jacgoudsmit/L-Star/(threads)

Thread 1 (2015-12-17):

Q: Would there be any major improvements for using a 6.25 MHz crystal?

cbmeeks, 2015-12-17:
I know timing is tight.  But, how would running the Propeller at 6.25 MHz (25 MIPS) enhance the emulation?  Assuming there would be any enhancements at all.

Do you think the 65C02 could be pushed closer to 2 MHz?

I hope to build this really soon.  :-)

From what I understand, the real limitations here are the pin counts and RAM.

Anyway, thanks for such a great project!!!

cbmeeks, 2015-12-17:
Sorry, I didn't see where you explicitly talked about this in the clock source.  Feel free to close this.

Thanks!

jacgoudsmit, 2015-12-17:
Hi cbmeeks.

While I was developing the Propeddle and L-Star, I was hoping I could make the 65(c)02 run faster than 1MHz, but there were several things that slowed things down, as compared to a (hypothetical) electronic solution instead of a sequential (programmed) solution.

For one thing, the Propeller only lets you read all the 32 pins at once. It doesn't allow a subset of the pins to be read. For this particular project, it would be great if I could use one single instruction to read the address bus or the data bus, without the need to shift/rotate the bits and/or mask them with a bitmask. That would save at least two instructions per 6502 cycle which is more than 10%.

Another problem is that it's almost unavoidable to have at least one hub instruction in the loop, and hub instructions take at least 8 Propeller cycles in the best case, or up to 23 cycles in the worst case. It took me a long time to design the original main loop of Propeddle in such a way that it would finish on time for the next 6502 cycle because of this.

If you want to run the 6502 faster while bitbanging it with a Propeller, you can probably do so if you add more electronics. My purpose with Propeddle and L-Star was to provide a flexible platform that could emulate many 1MHz 6502 systems (or could be used to design your own, to some extent). But if you want to use my ideas for something more specific, you can. For example, the Superboard III computer by Vince Briel at brielcomputers.com uses many of my ideas, but has an extenal address decoder to re-code the four address bus lines A15-A12 into three "virtual" address lines VA14-VA12 which made the logic for the Propeller firmware a little simpler and saved an I/O pin. If you want to use a separate Propeller just for video, for example, you can save a lot of pins too, by using an external address decoder. You could even make a system where the Propeller is sort of a GPU: just "send" it a command to draw (say) a circle and it does it without letting the 6502 wait, and such a system would only need 10 pins to interface with the 6502: a Chip Enable of sorts (with an external address decoder), the R/~W line and 8 data bus lines.

And you could do something that many 6502 systems from the 1980s did: run the 6502 on 2MHz or even faster for access to memory (using fast SRAM and 74F or 74AC address decoding logic for example) and slow the clock down or drop the RDY line to generate wait states when something needs to be done by the Propeller or some other slow peripherals.

Good luck!

cbmeeks, 2015-12-18:
Thanks for the great information!

Haha...I've come to a similar conclusion.  Bottom line is that if you want more than 2MHz then you need external logic.  Either an entire Propeller running all 8 COGS to address memory (and that's still debatable) or discrete logic (or CPLD/FPGA) to handle address decoding.

I'm more than likely going to use an entire Propeller for video (and maybe audio) and have the CPU pass it commands.  The TMS9918 worked this way.  Many people hated that.  And for good reason.  You have to burn cycles to send a command and then more cycles to send address/data bytes.  A lot more work than a simple LDA #$10; STA $D000.

Of course you can do things to help out like having commands that allow paging and serializing bytes in so that consecutive bytes are just data bytes.  Very little overhead that way (TMS9918 also did this).

I'm brainstorming many ideas.  One idea is to have a "blitter" using the Propeller.  The 65C02 could send it some blitter commands and then the Propeller could move large amounts of RAM around the display memory, etc.

Effectively, it would be a sort of "copper list".  :-)

Oh, BTW, the way you bootstrap the 65C02 is genius.  Using the built in program counter of the 65C02 to save address line pins...cheating!!  But brilliant.  :-D

jacgoudsmit, 2015-12-18:
The bootstrapping method was Dennis Ferron's idea. In his "Prop-6502 laptop" project he used NOP instructions but those are 1-byte, 2 cycles so the address only increases once every other clock pulse, I improved it by using CMP immediate, which is a 2 byte, 2 cycle instruction so the download (or upload which is not implemented yet but should be pretty trivial) goes twice as fast.

Dennis used the Reset vector to download the bootstrap code, but I use NMI. The advantages are that I can do an upload or download (sort of a DMA by cheating operation) while the system is running (e.g. to emulate a floppy disk, to "insert a cartridge", or to implement a hibernate-and-resume by reading/writing from/to EEPROM). The NMI combined with the RTI instruction fixes the problem that the flags are destroyed by the repeated CMP instruction. Also, using NMI and keeping the NMI input low (it's edge-triggered) makes it impossible for other hardware to interrupt the process.

On the other hand, forcing an interrupt by executing a BRK instruction (and letting the Propeller check for the IRQ vector fetch) also gives an opportunity to do automatic downloads/uploads from the Propeller.

Closed 2015-12-17.

Thread 2 (2016-02-09):

Constantly resetting...

cbmeeks, 2016-02-09:
I've wired this up to a breadboard.  So far, I just have a Propeller and a 65C02 wired up.

I have tested the Propeller with a blinky demo and it seems to be stable.

When wire up the 65C02, it displays:

> L-STAR (c) 2014 JAC GOUDSMIT
> HUB RAM BYTES:

And it just repeats that over and over.  I am using the built-in Propeller tools serial terminal at 115200, echo on.

I've also connected the TV out and see the screen blinking.

I'm pretty sure I have proper decoupling caps on everything, getting 3.2xx volts at the 65C02.  Using a benchtop power supply.

Using a 5 MHz crystal.

Any ideas?

Thanks

jacgoudsmit, 2016-02-09:
I've seen this before; I think it happens when you don't have a Prop Plug connected. I think the schematic is missing a couple of pull-up resistors for P31 and Reset (propeller) so when you disconnect the Prop plug, those lines start floating and oscillating and catching interference and other nasty stuff.

If you add two 10K resistors -- one between 3.3V and P31, and one between 3.3V and the Reset pin on the propeller -- or leave the Prop Plug connected, the problem should go away. I think you can even leave the Prop plug connected with no USB connection.

Let me know if that works!

===Jac

cbmeeks, 2016-02-09:
Thanks for the quick reply.

Unfortunately, I've tried it with and without the PropPlug and it does the same thing either way.

Also, I need the PropPlug for the serial terminal.  :-)

I have a 10k pullup on P29 as per the schematics in the Propeller manual.  Plus, other spin programs work just fine.

jacgoudsmit, 2016-02-09:
Hmmm...

To check if it's a hardware problem or a software problem, try inserting this before the call to clock.Init in Apple1.spin (which should be the top level file).

```spin
  repeat
    i:=0
```

This should send the main cog into an infinite loop and you should see the entire message including the "16384" on the serial port and on the monitor. After that, nothing should happen. If it still keeps resetting, it's most likely a hardware problem, e.g. interference between the serial port or video output to the reset line, or a power level that sags too much once the program gets busy (you have the Propeller BOE pin grounded, right?)

If that works okay, move the `repeat i:=0` instruction below the clock.init call, then further down etc.

You may also want to try running the 65C02 at a lower frequency, to see if it makes a difference. Simply change the clock.init call parameter to another value. You can even change the clock module so it doesn't call freq.Synth, and then control the hw#PIN_CLK0 output pin some other way, e.g. with a toggle switch, or from the serial port. The 65C02 is fully static so you can run it as slowly as you want. With a 5MHz crystal, you can run it up to 1MHz otherwise some of the helper cogs may not be able to keep up, but lower speeds are always okay.

Another thing to try is to delete the video module (comment out all references to the "tv" object in SerKbd1TV.spin). In a similar way you can delete the keyboard module (remove all references to kbd in the SerKbd1TV.spin file). This might give you some idea where any hardware problems are coming from.

Let me know if any of this helps...

cbmeeks, 2016-02-09:
It's working!

OK, it was a hardware problem.  My "monster" breadboard that I built was dropping too much power.  I moved the bench power leads closer to the actual circuit and now I get a stable image.

Sweet!

My scope is now showing a good solid 1.000MHz signal with an occasional drop to 960KHz.  But that's probably due to interference, breadboard, etc.

Thanks!

Now, how do I use the Woz monitor?  lol
Or basic?

cbmeeks, 2016-02-09:
Never mind.  I figured it out.  :-)

It's totally working now.

Had to `3C00 R` and that jumped to BASIC.

AWESOME!!

Probably going to have a board made!  Do you have any extras to sell?

Thanks!

jacgoudsmit, 2016-02-09:
Great! Good to hear you got it working.

I think I have one unpopulated PCB for L-Star, I'll send you an email.

For those reading along: You can order PCB's [here](https://oshpark.com/shared_projects/ATxyrTo7). A list of parts is [here](https://www.mouser.com/ProjectManager/ProjectDetail.aspx?ProjectGUID=144CCFEE-70F9-44B8-83F5-9934C3685E55). NOTE: the OSHPark and Mouser files are based on the [initial release](https://github.com/jacgoudsmit/L-Star/releases/tag/0.1); I've made several minor changes to the hardware design since then, but the latest software should still work.

The BOM on mouser.com doesn't include a power supply, keyboard, monitor or Prop Plug. You will also need a computer running the Parallax Propeller Tool to build the software. NOTE: There are currently no build instructions but those who have experience with soldering should be able to put this together pretty easily.

cbmeeks, 2016-02-09:
Great!

Have you ever used http://www.pcbway.com for PCB's?

I love the purple look of OSH Park but PCB appears to be even cheaper (coming from China).

Bil Herd uses them according to his YouTube video.

Anyway, thanks for such an awesome project.  I've been trying to solder up a small protoboard for this but all of the wires are really a drag to solder.

Thanks!

Closed 2016-02-11.

Thread 3 (2016-02-10):

Question: In Clock.spin, how is the ~~ used?

cbmeeks, 2016-02-10:
I searched the manual and it mentions "Sign-Extend 15" for the ~~ directive but I'm not understanding how this applies to the following code from `Clock.spin`:

`' Initialize the clock and SDA pins as output, and set them both high for now,`
`' so that the 6502 access cogs can ready themselves by waiting for CLK0 to go low.`
`  outa[hw#pin_SDA]~~                                    '`
`  dira[hw#pin_SDA]~~                                    ' The SDA pin must remain high so the EEPROM doesn't get activated.`
`  outa[hw#pin_CLK0]~~                                   ' Override the clock with a high signal for now`
`  dira[hw#pin_CLK0]~~                                   ' Set CLK0 pin to output for Phase 0 clock`

1) What is the `~~` actually doing in these examples?

2)  What is the reason for setting the value of the pin (I assume HIGH) *before* the direction is set on the same pin?

Thanks!

_BTW, my apologies if the Parallax forums would be a better place to ask this since it applies to `Spin` more than `L-Star`.  Also, I wasn't sure how to flag this as a question instead of an issue._

jacgoudsmit, 2016-02-10:
1) The ~~ operator can be used in two ways: ~~X means sign-extend bit 15,
but X~~ means set all bits. So in those examples it simply sets the pins to
1 and the directions to output. See page 157 and 158 of the Propeller
Manual (v1.2).

2) Setting the value of a pin before setting the direction prevents extra
pulses on the output pin. After a Reset, the OUTA register is reset to 0,
so if I would change the direction first, the pin's output transistors
would go from a situation where they're not pulling the pin high or low, to
a situation where they're pulling the output low until the OUTA bit changes
after the next instruction. By setting the bits in OUTA first, followed by
setting the pin direction to Output, the pin changes from
not-pulling-high-or-low to pulling-low. This is not Propeller-specific or
L-Star specific, it's just a general principle for all situations where an
electronic part can pull a signal low or high or "none of the above"
(commonly referred to as High-Z).

===Jac

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

cbmeeks, 2016-02-10:
Yes, that makes sense.

Thanks for the explanation.

Closed 2016-02-11.

Thread 7 (2018-03-14):

No level shifters in design

BrianHoldsworth, 2018-03-14:
Well, I suppose this is not an "Issue" because your design obviously works fine without level shifters between the 5V 6502 and the 3.3V propeller. The only reason I am bringing it up is because I tried researching this on the Parallax forum and there was a strong consensus that level shifting was needed to use the Propeller with TTL parts like the 6502.

As a point of "community knowledge sharing", perhaps the rationale for your design without level-shifters can be added to the docs or part of a not-yet-seeded GitHub Wiki? Also any idea if the L-Star also works with an NMOS 6502 and its slightly different logic levels?

jacgoudsmit, 2018-03-14:
L-Star uses a Western Design Center 65C02 and runs it at 3.3V, not 5V. This is within the specifications of the WDC datasheet.

In fact, the only reason there is 5V on board is for the PS/2 keyboard and for future expansion boards (I've been thinking of changing the power supply circuit to put the 5V and 3.3V regulators in parallel instead of in series to allow more current for the 5V rail, but that's a possible future enhancement). If an expansion board will have 5V-only hardware, it may also need level shifters. I'm sure I will bring up the subject in the documentation for such expansion board!

The Propeller is not 5V tolerant according to the datasheet. I think I read on the Propeller forums that the Propeller has over-voltage protection (Zener) diodes on all I/O pins, but they're not designed to sink enough current. However, interfacing with 5V is possible: Chris Savage who used to work at Parallax, had an article on his website (I can't find it right now) saying you would need resistors of 2700 ohms between a 5V circuit and input pins on the Propeller, to protect the Propeller. When a Propeller pin is used as output, it's compatible with TTL, at least with TTL-HC.

L-Star was based on my earlier Propeddle project (elsewhere in my Github). On Propeddle, I made it possible to use either a regular 6502 (at 5V) or the WDC 65C02 (at 3.3V or 5V). I used 2700 ohm resistors in that circuit which could be shorted out when running on 3.3V. When using a 5V 6502, the resistors worked to protect the Propeller from the 5V from the 6502 and didn't seem to cause any problems when the Propeller was pulling the data bus high or low.

In conclusion:
- On L-Star by itself, this is not an issue because the entire system runs at 3.3V except for the PS/2 keyboard (and the PS/2 keyboard is connected to the Propeller through a voltage divider based on Parallax sample schematics). No level shifters are needed because the voltages are the same.
- My experience is that the NMOS 6502 at 5V can be interfaced with the Propeller at 3.3V by using 2700 Ohm resistors in series, but I didn't use an oscilloscope (or anything else) to verify that signals were within limits.
- I realize that "works for me" is not statistically valid but until I design an expansion board that runs on 5V, I won't have to worry about it. When I do, I'll be sure to bring up the subject in the documentation.

Thanks!

BrianHoldsworth, 2018-03-14:
Thanks for the detailed response and for sharing your knowledge on this topic. I completely missed that you were running the 65C02 at 3.3V, or that even being a possible solution.

Closed 2018-03-14.

Thread 8 (2019-03-05):

80-column 1pin driver

konimaru, 2019-03-05:
For the record (since the OBEX managed to break the link), there is an 80 column version (@80MHz) or the 1pin TV driver.

[80 column version](http://forums.parallax.com/discussion/comment/1265858/#Comment_1265858)

jacgoudsmit, 2019-03-05:
Thanks!

So far there hasn't been a need for an 80-column 1-pin driver in L-Star but it might come in handy in the future.

80 columns is not really readable on most standard definition color TV screens though...

konimaru, 2019-03-05:
Fair enough, anyway it's not getting lost (anymore). When I tested it I had a nice big 32" TV available. IIRC there is even an evidence picture in the forum thread.

I haven't looked in detail at your changes but did you move the font to hub RAM again?

jacgoudsmit, 2019-03-06:
I saw the picture in the thread. It looks great! My 14" Trinitron will
definitely show it as well as your monitor, but I've used 27" CRT color
TV's that make a mess out of anything over 64 columns.

Monochrome monitors also have higher resolutions of course. I wouldn't be
surprised if my 5" black and white CRT TV would generate 80 colums without
blurring things too much.

For the OSI project, I had to move the font to the hub because it's 256
characters (not 128). The font would fill the entire cog. Unfortunately
that means that if the video clock is too high, the code can't retrieve the
video data fast enough. I think I did some calculations and wrote some
comments in the module about how far you can go.

===Jac

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
