jacgoudsmit/L-Star/(list of files, drawings)

Other design files:
Hardware/Fritzing/L-Star.fzz
