jacgoudsmit/L-Star/Software/PET2001/Debug_1pinTV.spin

'' ┌──────────────────────────────────────────────────────────────────────────┐
'' │ One Pin TV Text Driver used as Debug screen                        v1.2x │
'' ├──────────────────────────────────────────────────────────────────────────┤
'' │  Authors:  (c) 2009 Eric Ball                        (original 1-pinTV)  │
'' │            (c) 2010 "Cluso99" (Ray Rodrick)          (almost rewrite)    │
'' │            (c) 2014 kuroneko (Marko Lukat)                               │
'' │            AiChip_SmallFont_Atari_lsb_001.spin       (font)              │
'' │  License   MIT License - See end of file for terms of use                │
'' ├──────────────────────────────────────────────────────────────────────────┤
'' │  Forum:    http://forums.parallax.com/forums/default.aspx?f=25&m=431556  │
'' └──────────────────────────────────────────────────────────────────────────┘
''
'' Original One Pin TV Text Driver demo (C) 2009-07-09 Eric Ball
'' Font included is from "AiChip_SmallFont_Atari_lsb_001.spin"  (by hippy???)
'' Modified/rewritten by Cluso99:
'' RR20100214   _rr015  working for 64x28 NTSC & 64x32 PAL @5MHz
''                        added debug to show calculated values
'' RR20100215   _rr016  remove msb font mode (if reqd, reverse the font in hub)
''              _rr017  remove standby check & function (i.e. do setup once only)
''              _rr018
''              _rr019  use cog screen buffer 1024 bytes (64x16)
''              _rr020  cog screen buffer (40x16)
'' RR20100219   _rr022  cog font (only lsb font supported)
''                       (works but short of font space)
''              _rr023  add inverse bit8
''              _rr025  remove calcs, fix for 5MHz 40x25 chars, ok
''                      test release
''              _rr026  remove all parameter calcs (use "1pinTV_calcs.spin" to calculate parameters)
''              _rr027  add ASCII subset to cog (not VT100)
''              _rr033  cls, bs, cr, lf working except does not scroll
'' RR20100220   _rr035  add flashing cursor, can, home, right, left, up, down (left/right bug)
''              _rr037  scroll, left, right working :-)
''              _rr038  test with 1-pin Keyboard
''              _rr040  automatically set for 5MHz,6.25, 6.5, 13.5MHz xtal values for ifrqa in xfrqa
'' RR20100226   _rr041  tested ok.
'' RR20100228   Debug version: Rename "Debug_1pinTV.spin" and modify.
''              Output methods: chr/out/tx, str, dec, hex
'' RR20100302   v1.01   add PAL parameters
'' RR20100304   v1.02   modify font to speed up pix generation (each long is stored in a seperate half font)
''                       saved 2 instrctions in :active loop
''              v1.03   add constants for 64x25 & 80x25 NTSC and test various clock frequencies
'' RR20100306   v1.04   remove double height option
'' RR20100315   v1.05   change call doblank2 -> doblank (saves space) at lines 1797
''                      movs vscl,xsync & movs vscl,xbackp s/be mov
'' RR20100318   v1.06   use hub TV cog code for screen buffer
''                        (note that for 80*25 DAT will need extending to prevent overwrite)
'' RR20100318   v1.07   DAT extended to take care in case screen is 80*25
'' RR20100318   v1.08   add methods clear, home, gotoxy, cr (in spin)
'' RR20100424   v1.10   improve documentation only
'' RR20100503   _rr050  code mods (MOVS VSCL,#...); new NTSC timing
''                      move vt100 tasks to blank line code
'' RR20100505   v1.20   include automatic parameter calculation as well as predefined versions
''                        add timing diagram
'' RR20100505   _rr051  code shrink for VT100 space; allow variable row size & fill hub when required;
''                      auto clear screen at start (reqd)
'' RR20100505   v1.25   release
'' ML20140506   v1.26   all features fully operational @80MHz
''              v1.27   gotoxy now passes cursor address to speed up operation
''
' ─────────────────────────────────────────────────────────────────────────────────────────────────
' * This routine displays 40/64/80 characters by 25 lines using an 8x8 pixel text font.
' * Other screen sizes are permitted but the font is fixed.
' * NTSC or PAL can be selected. A flashing cusor is automatically displayed.
' * Only 1 propeller pin is used with a simple series resistor to give TV B&W video out.
' * Ideally suited to an additional debug monitor in your program, or as main display terminal.
' * The driver resides in the cog, together with the font and a simple terminal emulator.
' * The screen buffer resides in hub re-using the codespace originaly occupied by the cog code,
'    resulting in a minimum hub footprint.
' * If required, the user program may also write to the screen buffer directly.
' * You may also be interested in the 1pinKBD driver which uses 1 propeller pin connected to a
'    PS2 style Keyboard (or some DIN5 and USB keyboards via an adapter cable/plug).
' ─────────────────────────────────────────────────────────────────────────────────────────────────
' ┌─────────────┬───────┬───────┬───────┬───────┬───────┐
' │             │ 80MHz │ 96MHz │100MHz │104MHz │108MHz │
' ├─────────────┼───────┼───────┼───────┼───────┼───────┤
' │ NTSC 40X25  │  Yes  │  Yes  │  Yes  │  Yes  │  Yes  │
' ├─────────────┼───────┼───────┼───────┼───────┼───────┤
' │ NTSC 60X25  │  Yes  │  Yes  │  Yes  │  Yes  │  Yes  │
' ├─────────────┼───────┼───────┼───────┼───────┼───────┤
' │ NTSC 64X25  │  Yes  │  Yes  │  Yes  │  Yes  │  Yes  │
' ├─────────────┼───────┼───────┼───────┼───────┼───────┤
' │ NTSC 64X28  │  Yes  │  Yes  │  Yes  │  Yes  │  Yes  │
' ├─────────────┼───────┼───────┼───────┼───────┼───────┤
' │ NTSC 80X25  │  Yes  │  Yes  │  Yes  │  Yes  │  Yes  │    NoINV  = Works with INVERSE removed
' ├─────────────┼───────┼───────┼───────┼───────┼───────┤   *NoINV* = Works with INVERSE removed, some flicker
' │ PAL  40X25  │  Yes  │  Yes  │  Yes  │  Yes  │  Yes  │
' ├─────────────┼───────┼───────┼───────┼───────┼───────┤
' │ PAL  60X25  │ NoINV │   ?   │   ?   │   ?   │   ?   │
' ├─────────────┼───────┼───────┼───────┼───────┼───────┤
' │ PAL  60X32  │ NoINV │   ?   │   ?   │   ?   │   ?   │
' ├─────────────┼───────┼───────┼───────┼───────┼───────┤
' │ PAL  64X25  │*NoINV*│   ?   │   ?   │   ?   │   ?   │
' ├─────────────┼───────┼───────┼───────┼───────┼───────┤
' │ PAL  64X32  │*NoINV*│   ?   │   ?   │   ?   │   ?   │
' ├─────────────┼───────┼───────┼───────┼───────┼───────┤
' │ PAL  80X25  │  No   │   ?   │   ?   │   ?   │   ?   │       PAL untested (as of 1.26)
' └─────────────┴───────┴───────┴───────┴───────┴───────┘
' To remove inverse (default), comment out these two lines in the DAT pasm code below (in the :active routine)
'  '           test    char, #$80      wc      ' inverse?    '<=== comment out to remove inverse (1of2)
'  '   if_c    xor     char, #$FF              ' inverse     '<=== comment out to remove inverse (2of2)
' ─────────────────────────────────────────────────────────────────────────────────────────────────
' 1-pin composite video (TV) circuit...
' Acknowledgement: Phil Pilgrim for the circuit and Eric Ball for the original driver
'
'                              270R(*124R)
'   Prop tvPin Pxx (P14) ─────────────────────┳──┳───────────────────────┐
'                        ──┐          (*191R)nc    nc(*470pF)          ┌• TV
'                          ┴                    ┴  ┴                     ┴
'                  *see http://forums.parallax.com/forums/default.aspx?f=25&m=340731&g=342216
'
' Note: * 1 pin works with any TV resistor (100R - 1K1) without the RC network although 270R is preferred.
'       * If you want to try this out, you can use the existing video circuitry (TV) without change.
'       * See the Propeller Forum http://forums.parallax.com/forums/default.aspx?f=25&m=431556 for
'          more information including how to build a cable.
' ─────────────────────────────────────────────────────────────────────────────────────────────────
' To use this routine in your program, simply add the following...
' OBJ
'   tv    :      "Debug_1pinTV"
' PUB main
'   tv.start(tvPinc)                                      'start the Debug 1pinTV driver
'   tv.chr(0)                                             'cls (clear the screen)
' ─────────────────────────────────────────────────────────────────────────────────────────────────
{
 NTSC TV Timing  (80*25 with 8x8font)
 ==============
 frame
 line 1   2        3        4        5        6        7        8        9        10       11  /.../   41       42       43  /.../   241      242      243 /.../   262      next frame (second field)
 ├─────────┼─────────┼─────────┼─────────┼─────────┼─────────┼─────────┼─────────┼─────────┼─────────┼────/.../───┼─────────┼─────────┼────/.../───┼─────────┼─────────┼────/.../───┼─────────┼ H=63.555us per line

 lines x3 (equalising)        lines x3 (serration)         lines x3 (equalising)        lines x32 (blank)               lines x200 (active)             lines x21 (blank)                (add 1/2 line for interlace)
                                                                                                                               ┌────┐    ┌─/.../─┐    ┌────┐
 ┐┌───┐┌───┐┌───┐┌───┐┌───┐┌───┐   ┌┐   ┌┐   ┌┐   ┌┐   ┌┐   ┌┐┌───┐┌───┐┌───┐┌───┐┌───┐┌───┐┌────────┐┌───/.../───┐┌────────┐┌─┘────└─┐┌─┘─/.../─└─┐┌─┘────└─┐┌────────┐┌───/.../───┐┌────────
 └┘   └┘   └┘   └┘   └┘   └┘   └───┘└───┘└───┘└───┘└───┘└───┘└┘   └┘   └┘   └┘   └┘   └┘   └┘        └┘           └┘        └┘        └┘           └┘        └┘        └┘           └┘

 ├┤ p=2.3±0.1us (xequal)       ├───┤ q=27.1us (xsynch)       ├┤ p=2.3±0.1us (xequal)       ├┤ d=4.7±0.1us (xsync)           ├┤ d=4.7±0.1us (xsync)
  ├───┤ =29.477us (xequalh)        ├┤ r=4.7±0.1us (xsync)     ├───┤ =29.477us (xequalh)     ├───┤ q=27.1us (xsynch)          ├─┤ bp=~8.9us (xbackp)
 ├────┤ H/2=31.777us           ├────┤ H/2                    ├────┤ H/2                         ├────┤ H/2 (xhalf)             ├────┤ 8*80pixels (xvsclch)
                                                                                            ├────────┤     (xblank)                 ├─┤ fp=~5.9us (xfrontp)

reference www.kolumbus.fi/pami1/video/pal_ntsc.html
}

CON

'Select one of the following blocks by commenting/uncommenting using "{" ... "}"
'--------------------------------------------------------------------------------------------------

'  This is the "auto version"...
'    Just set the following 3 parameters and the rest will be calculated automatically.
'
PAL                     =       0                       ' 0 = NTSC, 1 = PAL
ocols                   =       40                      ' number of columns (MAXIMUM =80?)
orows                   =       25                      ' number of rows    (MAXIMUM NTSC=28, PAL=32)
'
'  The following are calculated automatically.
ofrqa                   =       ocolsfrq * ocols * 8                            'PLLA CTRA Freq
ohalf                   =       ofrqa / linefrq / 2                             'ohalf
osync                   =       tsync / 100 * ofrqa / 1_000_000_0
t1                      =       tbackp / 100 * ofrqa / 1_000_000_0              'back porch min time
t2                      =       tfrontp / 100 * ofrqa / 1_000_000_0             'front porch min time
'now average the remaining line time between back porch and front porch
obackp                  =       (ohalf + ohalf - osync - t1 - (ocols * 8) - t2) / 2 + t1  'back porch
plldiv                  =       >|((ofrqa - 1) / 1_000_000)                     'determine PLLDIV
ictra                   =       (%00001 << 3) | plldiv                          'ctrmode + plldiv (internal video mode)
linefrq                 =       (15_734 * (1-PAL)) + (15_625 * PAL)   ' Line Freq (NTSC=15.734KHz, PAL=15.625KHz)
ocolsfrq                =       (22_478 * (1-PAL)) + (22_321 * PAL)   ' Hz per active pixel (NTSC=22478, PAL=22321)
linesh                  =       (525 / 2 * (1-PAL)) + (625 / 2 * PAL) ' lines per frame (NTSC=262, PAL=312)
tsync                   =       4700                                  ' time (ns) of sync pulse (4.7us)
tbackp                  =       (4500 * (1-PAL)) + (5800 * PAL)       ' time (ns) used in backp calc (NTSC=4.5us, PAL=5.8us)
tfrontp                 =       1500                                  ' time (ns) used in frontp calc (1.5us)
oserr                   =       6        '- (PAL * 1)                 ' no. of equal/serr/equal pulses (NTSC=6, PAL=6 was 5)
oblank0                 =       linesh - (3*oserr/2) - (orows*8)      ' total blank lines  (typ: NTSC=53, PAL=104)
oblank0a                =       (11 * (1-PAL)) + (14 * PAL)           ' no. extra blank lines top (NTSC=11, PAL=14)
oblank1                 =       ((oblank0 - oblank0a) / 2) + oblank0a ' no. of blank lines top (typ: NTSC=32, PAL=58)
oblank2                 =       oblank0 - oblank1                     ' no. of blank lines bot.(typ: NTSC=21, PAL=45)
oactive                 =       orows * 8                             ' no. of active lines
oequal                  =       osync / 2                             ' VSCL equalization pulse (sync/2)
osynch                  =       ohalf - osync                         ' VSCL half-sync
oequalh                 =       ohalf - oequal                        ' VSCL half-equal
ofrontp                 =       (2*ohalf) -osync -obackp -(ocols*8)   ' VSCL front porch (active to sync)
ovsclch                 =       8                                     ' VSCL character (8 PLLA per frame = pixels/char)

'--------------------------------------------------------------------------------------------------
{
'' NTSC 40x25
PAL                     =       0                       ' 0 = NTSC, 1 = PAL
ocols                   =       40                      ' number of columns
orows                   =       25                      ' number of rows
ocolsfrq                =       22_478                  ' Hz per active pixel NTSC
oserr                   =       6                       ' number of equalisation/serration/equalisation pulses
oblank1                 =       32                      ' number of blank lines
oactive                 =       200                     ' number of active lines
oblank2                 =       21                      ' number of blank lines
ohalf                   =       228                     ' VSCL half line
osync                   =       33                      ' VSCL sync pulse
osynch                  =       195                     ' VSCL half-sync
oequal                  =       16                      ' VSCL equalization pulse (sync/2)
oequalh                 =       212                     ' VSCL half-equal
obackp                  =       62                      ' VSCL back porch (sync to active)
ofrontp                 =       41                      ' VSCL front porch (active to sync)
ovsclch                 =       8                       ' VSCL character
ictra                   =       8+3 '11                 ' CTRA with PLLdiv %0_00001_100

ifrqa_80MHz             =       386169088               ' required FRQA value (5MHz*16)
ifrqa_96MHz             =       321807584               ' required FRQA value (6MHz*16)
ifrqa_100MHz            =       308935280               ' required FRQA value (6.25MHz*16)
ifrqa_104MHz            =       297053152               ' required FRQA value (6.5MHz*16)
ifrqa_108MHz            =       286051184               ' required FRQA value (13.5MHz*8)
}
'--------------------------------------------------------------------------------------------------
{
'' NTSC 60x25
PAL                     =       0                       ' 0 = NTSC, 1 = PAL
ocols                   =       60                      ' number of columns
orows                   =       25                      ' number of rows
ocolsfrq                =       22_478                  ' Hz per active pixel NTSC
oserr                   =       6                       ' number of equalisation/serration/equalisation pulses
oblank1                 =       32                      ' number of blank lines
oactive                 =       200                     ' number of active lines
oblank2                 =       21                      ' number of blank lines
ohalf                   =       342                     ' VSCL half line
osync                   =       50                      ' VSCL sync pulse
osynch                  =       292                     ' VSCL half-sync
oequal                  =       25                      ' VSCL equalization pulse (sync/2)
oequalh                 =       317                     ' VSCL half-equal
obackp                  =       93                      ' VSCL back porch (sync to active)
ofrontp                 =       61                      ' VSCL front porch (active to sync)
ovsclch                 =       8                       ' VSCL character
ictra                   =       8+4 '12                 ' CTRA with PLLdiv

ifrqa_80MHz             =       289626816               ' required FRQA value (5MHz*16)
ifrqa_96MHz             =       241355680               ' required FRQA value (6MHz*16)
ifrqa_100MHz            =       231701456               ' required FRQA value (6.25MHz*16)
ifrqa_104MHz            =       222789856               ' required FRQA value (6.5MHz*16)
ifrqa_108MHz            =       214538384               ' required FRQA value (13.5MHz*8)
}
'--------------------------------------------------------------------------------------------------
{
'' NTSC 64x25
PAL                     =       0                       ' 0 = NTSC, 1 = PAL
ocols                   =       64                      ' number of columns
orows                   =       25                      ' number of rows
ocolsfrq                =       22_478                  ' Hz per active pixel NTSC
oserr                   =       6                       ' number of equalisation/serration/equalisation pulses
oblank1                 =       32                      ' number of blank lines
oactive                 =       200                     ' number of active lines
oblank2                 =       21                      ' number of blank lines
ohalf                   =       365                     ' VSCL half line
osync                   =       54                      ' VSCL sync pulse
osynch                  =       311                     ' VSCL half-sync
oequal                  =       27                      ' VSCL equalization pulse (sync/2)
oequalh                 =       338                     ' VSCL half-equal
obackp                  =       99                      ' VSCL back porch (sync to active)
ofrontp                 =       65                      ' VSCL front porch (active to sync)
ovsclch                 =       8                       ' VSCL character
ictra                   =       8+4 '12                 ' CTRA with PLLdiv

ifrqa_80MHz             =       308935280               ' required FRQA value (5MHz*16)
ifrqa_96MHz             =       257446064               ' required FRQA value (6MHz*16)
ifrqa_100MHz            =       247148224               ' required FRQA value (6.25MHz*16)
ifrqa_104MHz            =       237642512               ' required FRQA value (6.5MHz*16)
ifrqa_108MHz            =       228840944               ' required FRQA value (13.5MHz*8)
}
'--------------------------------------------------------------------------------------------------
{
'' NTSC 80x25
PAL                     =       0                       ' 0 = NTSC, 1 = PAL
ocols                   =       80                      ' number of columns
orows                   =       25                      ' number of rows
ocolsfrq                =       22_478                  ' Hz per active pixel NTSC
oserr                   =       6                       ' number of equalisation/serration/equalisation pulses
oblank1                 =       32                      ' number of blank lines
oactive                 =       200                     ' number of active lines
oblank2                 =       21                      ' number of blank lines
ohalf                   =       424                     ' VSCL half line
osync                   =       63                      ' VSCL sync pulse
osynch                  =       361                     ' VSCL half-sync
oequal                  =       31                      ' VSCL equalization pulse (sync/2)
oequalh                 =       393                     ' VSCL half-equal
obackp                  =       67                      ' VSCL back porch (sync to active)
ofrontp                 =       78                      ' VSCL front porch (active to sync)
ovsclch                 =       8                       ' VSCL character
ictra                   =       8+4 '12                 ' CTRA with PLLdiv

ifrqa_80MHz             =       357908215 '386169088    ' required FRQA value (5MHz*16)
ifrqa_96MHz             =       321807584               ' required FRQA value (6MHz*16)
ifrqa_100MHz            =       308935280               ' required FRQA value (6.25MHz*16)
ifrqa_104MHz            =       297053152               ' required FRQA value (6.5MHz*16)
ifrqa_108MHz            =       286051184               ' required FRQA value (13.5MHz*8)
}
'--------------------------------------------------------------------------------------------------
{
'' PAL  40x25
PAL                     =       1                       ' 0 = NTSC, 1 = PAL
ocols                   =       40                      ' number of columns
orows                   =       25                      ' number of rows
ocolsfrq                =       22_321                  ' Hz per active pixel PAL
oserr                   =       6 '5                    ' number of equalisation/serration/equalisation pulses
oblank1                 =       59                      ' number of blank lines
oactive                 =       200                     ' number of active lines
oblank2                 =       45                      ' number of blank lines
ohalf                   =       228                     ' VSCL half line
osync                   =       33                      ' VSCL sync pulse
osynch                  =       195                     ' VSCL half-sync
oequal                  =       16                      ' VSCL equalization pulse (sync/2)
oequalh                 =       212                     ' VSCL half-equal
obackp                  =       66                      ' VSCL back porch (sync to active)
ofrontp                 =       37                      ' VSCL front porch (active to sync)
ovsclch                 =       8                       ' VSCL character
ictra                   =       8+3 '11                 ' CTRA with PLLdiv

ifrqa_80MHz             =       383471856               ' required FRQA value (5MHz*16)
ifrqa_96MHz             =       319559872               ' required FRQA value (6MHz*16)
ifrqa_100MHz            =       306777488               ' required FRQA value (6.25MHz*16)
ifrqa_104MHz            =       294978352               ' required FRQA value (6.5MHz*16)
ifrqa_108MHz            =       284053216               ' required FRQA value (13.5MHz*8)
}
'--------------------------------------------------------------------------------------------------
{
'' PAL  60x25
PAL                     =       1                       ' 0 = NTSC, 1 = PAL
ocols                   =       60                      ' number of columns
orows                   =       25                      ' number of rows
ocolsfrq                =       22_321                  ' Hz per active pixel PAL
oserr                   =       6 '5                    ' number of equalisation/serration/equalisation pulses
oblank1                 =       59                      ' number of blank lines
oactive                 =       200                     ' number of active lines
oblank2                 =       45                      ' number of blank lines
ohalf                   =       342                     ' VSCL half line
osync                   =       50                      ' VSCL sync pulse
osynch                  =       292                     ' VSCL half-sync
oequal                  =       25                      ' VSCL equalization pulse (sync/2)
oequalh                 =       317                     ' VSCL half-equal
obackp                  =       100                     ' VSCL back porch (sync to active)
ofrontp                 =       54                      ' VSCL front porch (active to sync)
ovsclch                 =       8                       ' VSCL character
ictra                   =       8+4 '12                 ' CTRA with PLLdiv

ifrqa_80MHz             =       287603888               ' required FRQA value (5MHz*16)
ifrqa_96MHz             =       239669904               ' required FRQA value (6MHz*16)
ifrqa_100MHz            =       230083104               ' required FRQA value (6.25MHz*16)
ifrqa_104MHz            =       221233760               ' required FRQA value (6.5MHz*16)
ifrqa_108MHz            =       213039920               ' required FRQA value (13.5MHz*8)
}
'--------------------------------------------------------------------------------------------------
{
'' PAL  64x25
PAL                     =       1                       ' 0 = NTSC, 1 = PAL
ocols                   =       64                      ' number of columns
orows                   =       25                      ' number of rows
ocolsfrq                =       22_321                  ' Hz per active pixel PAL
oserr                   =       6 '5                    ' number of equalisation/serration/equalisation pulses
oblank1                 =       59                      ' number of blank lines
oactive                 =       200                     ' number of active lines
oblank2                 =       45                      ' number of blank lines
ohalf                   =       365                     ' VSCL half line
osync                   =       53                      ' VSCL sync pulse
osynch                  =       312                     ' VSCL half-sync
oequal                  =       26                      ' VSCL equalization pulse (sync/2)
oequalh                 =       339                     ' VSCL half-equal
obackp                  =       107                     ' VSCL back porch (sync to active)
ofrontp                 =       58                      ' VSCL front porch (active to sync)
ovsclch                 =       8                       ' VSCL character
ictra                   =       8+4 '12                 ' CTRA with PLLdiv

ifrqa_80MHz             =       306777488               ' required FRQA value (5MHz*16)
ifrqa_96MHz             =       255647904               ' required FRQA value (6MHz*16)
ifrqa_100MHz            =       245421984               ' required FRQA value (6.25MHz*16)
ifrqa_104MHz            =       235982672               ' required FRQA value (6.5MHz*16)
ifrqa_108MHz            =       227242576               ' required FRQA value (13.5MHz*8)
}
'--------------------------------------------------------------------------------------------------
{
'' PAL  80x25
PAL                     =       1                       ' 0 = NTSC, 1 = PAL
ocols                   =       80                      ' number of columns
orows                   =       25                      ' number of rows
ocolsfrq                =       22_321                  ' Hz per active pixel PAL
oserr                   =       5                       ' number of equalisation/serration/equalisation pulses
oblank1                 =       60 '59                  ' number of blank lines
oactive                 =       200                     ' number of active lines
oblank2                 =       45                      ' number of blank lines
ohalf                   =       457                     ' VSCL half line
osync                   =       67                      ' VSCL sync pulse
osynch                  =       390                     ' VSCL half-sync
oequal                  =       33                      ' VSCL equalization pulse (sync/2)
oequalh                 =       424                     ' VSCL half-equal
obackp                  =       134                     ' VSCL back porch (sync to active)
ofrontp                 =       73                      ' VSCL front porch (active to sync)
ovsclch                 =       8                       ' VSCL character
ictra                   =       8+4 '12                 ' CTRA with PLLdiv

ifrqa_80MHz             =       383471956               ' required FRQA value (5MHz*16)
ifrqa_96MHz             =       319559872               ' required FRQA value (6MHz*16)
ifrqa_100MHz            =       306777488               ' required FRQA value (6.25MHz*16)
ifrqa_104MHz            =       294978352               ' required FRQA value (6.5MHz*16)
ifrqa_108MHz            =       284053216               ' required FRQA value (13.5MHz*8)
}

'--------------------------------------------------------------------------------------------------
'The following are required for all video versions
_xFRQB  =       $4924_0000      ' 40/140 << 32 = 1,227,096,064 (generate PWM for black pixels)
_iCTRB  =       %0_00110_000    ' single ended duty (turn on blank = black)
_iVCFG  =       %0_01_0_0_0_000 ' VGA mode, 1 bit per pixel

'--------------------------------------------------------------------------------------------------
'ASCII screen codes
_cls    =       0               'clear screen
_bel    =       7               'bell                   (not implemented)
_bs     =       8               'backspace
_ht     =       9               'horiz tab              (not implemented)
_lf     =       10              'line feed
_vt     =       11              'vert tab = home
_ff     =       12              'formfeed               (not implemented)
_cr     =       13              'carriage return
_can    =       24              'cancel = clear screen
_esc    =       27              'escape                 (not implemented)
_fs     =       28              'right
_gs     =       29              'left
_rs     =       30              'up
_us     =       31              'down
_spc    =       32              'space

flash   =       1<<4            'cursor flash rate  (change to 1<<4 etc to slow down)


VAR
  long  cog
  long  pRENDEZVOUS                                     'buffer to pass characters to 1pinTV driver

PUB start(tvPin)                                        'pass tv pin#

  ifnot cog
    xfrqa := Setforxtalfreq                             'set xfrqa in hub for the current clkfreq before cognew
    pRENDEZVOUS := @screen << 8 | tvPin                 'pass parameters (screen address in hub & pin#)
    if result := cog := cognew(@entry, @pRendezvous) + 1
      repeat while pRENDEZVOUS                          'wait until cleared

  return @screen

PUB stop

  if cog > 0
    cogstop(cog~~ - 1)

PRI Setforxtalfreq : f | Freq, PropFreq, shift
'' Return frqa value for the current clkfreq
'' Derived from CTR.SPIN by Chip Gracey

  Freq := constant(ocolsfrq * ocols * 8)                'frequency required
  shift := 4 - >|((Freq - 1) / 1_000_000)               'determine shift
  PropFreq := clkfreq

  if shift > 0                                          'if shift, pre-shift Freq or PropFreq left
    Freq <<= shift                                      'to maintain significant bits while
  if shift < 0                                          'insuring proper result
    PropFreq <<= -shift

  repeat 32                                             'perform long division of Freq / PropFreq
    f <<= 1
    if Freq => PropFreq
      Freq -= PropFreq
      f++                                               'compute frqa value
    Freq <<= 1

PUB out(c)                                              'compatability
    chr(c)

PUB tx(c)                                               'compatability
    chr(c)

PUB chr(c)                                              'can be changed to OUT or TX
'' Print a character

  c |= $100   '0.FF -> 100..1FF                         'add bit9=1 (allows $00 to be passed)
  repeat while pRENDEZVOUS                              'wait for mailbox to be empty (=$0)
  pRENDEZVOUS := c                                      'place in mailbox for driver to act on

PUB str(stringptr)
'' Print a zero-terminated string

  repeat strsize(stringptr)
    chr(byte[stringptr++])

PUB dec(value) | s[4], p
'' Print a decimal number

  s{0} := value < 0                                     ' remember sign

  p := @p                                               ' initialise string pointer
  byte[--p] := 0                                        ' terminate string
  
  repeat
    byte[--p] := ||(value // 10) + "0"                  ' |
    value /= 10                                         ' |
  while value                                           ' create decimal representation

  if s{0}                                               ' optionally
    byte[--p] := "-"                                    ' prepend sign

  str(p)                                                ' emit string
  
PUB hex(value, digits)
'' Print a hexadecimal number

  value <<= (8 - digits) << 2
  repeat digits
    chr(lookupz((value <-= 4) & $F : "0".."9", "A".."F"))

PUB bin(value, digits)
'' Print a binary number

  value <<= 32 - digits
  repeat digits
    chr((value <-= 1) & 1 + "0")

PUB clear
'' Clear screen
  chr(_cls)

PUB home
'' Cursor home
  chr(_vt)

PUB gotoxy(x, y)
'' Position cursor x=col, y=row  (0,0 =home)

  chr((y*ocols+x) << 16 | _vt)                          ' this is inherently dangerous

PUB cr
'' Carriage return
  chr(_cr)


DAT                     org     0
'  ┌──────────────────────────────────────────────────────────────────────────┐
'  │ NOTE: The screen buffer will overlay the hub space used by the           │
'  │         following DAT code to save precious space.                       │
'  └──────────────────────────────────────────────────────────────────────────┘

'  ┌──────────────────────────────────────────────────────────────────────────┐
'  │ Font section:  128 characters of 8x8 font                                │
'  │                two blocks of 128 longs of 4x8 (4 rows of 8 pixels)       │
'  ├──────────────────────────────────────────────────────────────────────────┤
'  │ Derived from:  AiChip_SmallFont_Atari_lsb_001.spin                       │
'  │                LSB first version of Font_ATARI from AiGeneric Text Driver│
'  └──────────────────────────────────────────────────────────────────────────┘
'  The font is located at the beginning of the cog ram to speed up the code

entry                                                   '\
screen                                                  '|  screen will use this hub space once cog is loaded
fonttab                                                 '|  font starts here also...
                        jmp     #setup                  '/  go & replace this instr with the first font long

'fonttab                byte    %00000000               ' ........    $00     \ replaces the above jmp
'                       byte    %00000000               ' ........            |
'                       byte    %00000000               ' ........            |
'                       byte    %00011000               ' ...##...            /

                        byte    %00001111               ' ####....    $01
                        byte    %00001111               ' ####....
                        byte    %00001111               ' ####....
                        byte    %00001111               ' ####....

                        byte    %00000000               ' ........    $02  USED FOR CURSOR
                        byte    %00000000               ' ........
                        byte    %00000000               ' ........
                        byte    %00000000               ' ........

                        byte    %11111111               ' ########    $03
                        byte    %11111111               ' ########
                        byte    %11111111               ' ########
                        byte    %11111111               ' ########

                        byte    %00000000               ' ........    $04
                        byte    %00000000               ' ........
                        byte    %00000000               ' ........
                        byte    %00000000               ' ........

                        byte    %00001111               ' ####....    $05
                        byte    %00001111               ' ####....
                        byte    %00001111               ' ####....
                        byte    %00001111               ' ####....

                        byte    %11110000               ' ....####    $06
                        byte    %11110000               ' ....####
                        byte    %11110000               ' ....####
                        byte    %11110000               ' ....####

                        byte    %11111111               ' ########    $07
                        byte    %11111111               ' ########
                        byte    %11111111               ' ########
                        byte    %11111111               ' ########

                        byte    %00000000               ' ........    $08
                        byte    %00000000               ' ........
                        byte    %00000000               ' ........
                        byte    %00000000               ' ........

                        byte    %00001111               ' ####....    $09
                        byte    %00001111               ' ####....
                        byte    %00001111               ' ####....
                        byte    %00001111               ' ####....

                        byte    %11110000               ' ....####    $0A
                        byte    %11110000               ' ....####
                        byte    %11110000               ' ....####
                        byte    %11110000               ' ....####

                        byte    %11111111               ' ########    $0B
                        byte    %11111111               ' ########
                        byte    %11111111               ' ########
                        byte    %11111111               ' ########

                        byte    %00000000               ' ........    $0C
                        byte    %00000000               ' ........
                        byte    %00000000               ' ........
                        byte    %00000000               ' ........

                        byte    %00001111               ' ####....    $0D
                        byte    %00001111               ' ####....
                        byte    %00001111               ' ####....
                        byte    %00001111               ' ####....

                        byte    %11110000               ' ....####    $0E
                        byte    %11110000               ' ....####
                        byte    %11110000               ' ....####
                        byte    %11110000               ' ....####

                        byte    %11111111               ' ########    $0F
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

                        byte    %01100110               ' .##..##.    $79  y
                        byte    %01111100               ' ..#####.
                        byte    %00110000               ' ....##..
                        byte    %00011110               ' .####...

                        byte    %00011000               ' ...##...    $7A  z
                        byte    %00001100               ' ..##....
                        byte    %01111110               ' .######.
                        byte    %00000000               ' ........

                        byte    %00011110               ' .###....    $7B  {
                        byte    %00011000               ' ...##...
                        byte    %00111000               ' ...###..
                        byte    %00000000               ' ........

                        byte    %00011000               ' ...##...    $7C  |
                        byte    %00011000               ' ...##...
                        byte    %00011000               ' ...##...
                        byte    %00011000               ' ...##...

                        byte    %01111000               ' ....###.    $7D  }
                        byte    %00011000               ' ...##...
                        byte    %00011100               ' ..###...
                        byte    %00000000               ' ........

                        byte    %00000000               ' ........    $7E  ~
                        byte    %00000000               ' ........
                        byte    %00000000               ' ........
                        byte    %00000000               ' ........

                        byte    %00011100               ' ..###...    $7F
                        byte    %00000000               ' ........
                        byte    %00000000               ' ........
                        byte    %00000000               ' ........

' end of font

'  ┌──────────────────────────────────────────────────────────────────────────┐
'  │ 1pin TV Video driver section                                             │
'  └──────────────────────────────────────────────────────────────────────────┘

'**************************************************************************************************
'Display a frame (1 screen full) non-interlaced B&W
frame                   add     fcnt, #1                ' inc frame counter
'--------------------------------------------------------------------------------------------------
                        call    #equalizing             ' equalisation pulses (6 sets = 3 lines)
'--------------------------------------------------------------------------------------------------
                        movs    pulse1, #xsynch         ' \setup serrations: addr of xsynch
                        movs    pulse2, #osync          ' /                  value of osync
                        call    #equalizing             ' serration pulses    (6 sets = 3 lines)
                        movs    pulse1, #xequal         ' \restore equalizg: addr of xequal
                        movs    pulse2, #oequalh        ' /                  value of oequalh
'--------------------------------------------------------------------------------------------------
                        call    #equalizing             ' equalisation pulses (6 sets = 3 lines)
'==================================================================================================
                        mov     rcnt, #oblank1
                        call    #doblank                ' blank lines (top)
'==================================================================================================
'Display active lines (horiz sync & setup)
                        mov     rcnt, #oactive          ' no. of active visible lines (rows*fontrows)
                        mov     cptr, sptr wc           ' initialize character pointer

' entry condition carry set, repeat carry clear

doactive                mov     vscl, xsync             ' horiz sync (line)
                        waitvid xFFOO, #0
                        movi    ctrb, #0                ' turn off blank

                        test    rcnt, #7 wz             ' 8 lines per row (new char row?)
        if_z_and_nc     add     cptr, #ocols            ' advance during first line of each row >0
        if_z            mov     fshr, #0                ' reset if required (new char row)
        if_nz           add     fshr, #1*8              ' advance to next column (x8 to simplify maths)
                        test    fshr, #4*8 wz           ' set nz flag for upper long (pixel rows 5..8)

                        add     cptr, #quads * 4 -1     ' address of last byte
                        movi    cptr, #quads     -2     ' add magic marker

                        movs    vscl, #obackp           ' back porch (before video pixel line)
                        waitvid xFFOO, #0
                        movi    ctrb, #_iCTRB           ' turn on blank
'--------------------------------------------------------------------------------------------------
'Display entire pixel line (screen is in hub, font is in cog)
                        movs    vscl, #ovsclch          ' 8 PLLA per frame (fontcols)

:load_7                 rdlong  line+quads-1, cptr      ' 2n enforced
                        sub     $-1, dst2
                        sub     cptr, i2s7 wc
:load_1                 rdlong  line+quads-2, cptr      ' 2n enforced
                        sub     $-1, dst2
                if_nc   djnz    cptr, #:load_7

' char is aliased to the first quad, i.e. already loaded

                        mov     count, #ocols/4         ' load (real) quad count

:loop_Q                 test    char, #$80 wc           ' inverse?
                        muxnz   char, #$80              ' redirect to high/low table
                        movs    :getfont_0, char        ' inject source
                        andn    :getfont_0, #256        ' 0..255

                        shr     char, #8                ' next character

:getfont_0              mov     temp, 0-0               ' get font
                        shr     temp, fshr              ' shift pixels 0/8/16/24 (upper pixels ignored)
                if_c    xor     temp, #$FF              ' !pattern
                        waitvid xFFOO, temp             ' output to screen

                        test    char, #$80 wc           ' inverse?
                        muxnz   char, #$80              ' redirect to high/low table
                        movs    :getfont_1, char        ' inject source
                        andn    :getfont_1, #256        ' 0..255

                        shr     char, #8                ' next character

:getfont_1              mov     temp, 0-0               ' get font
                        shr     temp, fshr              ' shift pixels 0/8/16/24 (upper pixels ignored)
                if_c    xor     temp, #$FF              ' !pattern
                        waitvid xFFOO, temp             ' output to screen

                        test    char, #$80 wc           ' inverse?
                        muxnz   char, #$80              ' redirect to high/low table
                        movs    :getfont_2, char        ' inject source
                        andn    :getfont_2, #256        ' 0..255

                        shr     char, #8                ' next character

:getfont_2              mov     temp, 0-0               ' get font
                        shr     temp, fshr              ' shift pixels 0/8/16/24 (upper pixels ignored)
                if_c    xor     temp, #$FF              ' !pattern
                        waitvid xFFOO, temp             ' output to screen

                        test    char, #$80 wc           ' inverse?
                        muxnz   char, #$80              ' redirect to high/low table
                        movs    :getfont_3, char        ' inject source

:load_Q                 mov     char, line+1            ' load next quad
                        add     $-1, #1                 ' advance            

:getfont_3              mov     temp, 0-0               ' get font
                        shr     temp, fshr              ' shift pixels 0/8/16/24 (upper pixels ignored)
                if_c    xor     temp, #$FF              ' !pattern
                        waitvid xFFOO, temp             ' output to screen

                        djnz    count, #:loop_Q         ' for all quad columns

                        movs    :load_Q, #line+1        ' reset
                        movd    :load_1, #line+quads-2  ' |
                        movd    :load_7, #line+quads-1  ' |
'--------------------------------------------------------------------------------------------------
                        movs    vscl, #ofrontp          ' front porch (after video pixel line)
                        waitvid xFFOO, #0
                        djnz    rcnt, #doactive wc      ' next row (carry clear)
'==================================================================================================
                        mov     rcnt, #oblank2
                        call    #doblank                ' blank lines (bottom)
'==================================================================================================
                        jmp     #frame
'**************************************************************************************************

'equalisation and serration pulses
equalizing              mov     rcnt, #oserr            ' =6 pulses
pulse1                  mov     vscl, xequal-0          ' equalizing short / serration long
                        waitvid xFFOO, #0
                        movi    ctrb, #0                ' turn off blank
pulse2                  movs    vscl, #oequalh-0        ' equalizing long / serration short
                        waitvid xFFOO, #0
                        movi    ctrb, #_iCTRB           ' turn on blank
                        djnz    rcnt, #pulse1
equalizing_ret          ret
'--------------------------------------------------------------------------------------------------
'do blank lines (top & bottom)
doblank                 mov     vscl, xsync             ' horiz sync (line)
                        waitvid xFFOO, #0
                        movi    ctrb, #0                ' turn off blank
                        mov     vscl, xblank            ' line
                        waitvid xFFOO, #0
                        movi    ctrb, #_iCTRB           ' turn on blank
                        jmpret  taskptr, taskptr        ' to vt100 code
                        jmpret  taskptr, taskptr        ' to vt100 code
                        djnz    rcnt, #doblank
doblank_ret             ret

' initialised data and/or presets

xequal                  long    1<<12 | oequal          ' 1 PLLA per pixel + equalisation time
xsynch                  long    1<<12 | osynch          ' 1 PLLA per pixel + serration time
xsync                   long    1<<12 | osync           ' 1 PLLA per pixel + sync time
xblank                  long    1<<12 | osynch+ohalf    ' 1 PLLA per pixel + blank line (maybe > 9bits so MOVS fails)
xFFOO                   long    $FF00                   ' white / black

count                   long    1                       ' all purpose counter (preset)
dst2                    long    2 << 9                  ' dst +/-= 2
i2s7                    long    2 << 23 | 7             ' loader support

'  ┌──────────────────────────────────────────────────────────────────────────┐
'  │ Video Terminal driver section (basic functions like VT100)               │
'  └──────────────────────────────────────────────────────────────────────────┘
'  Tasks - performed during blank lines

cls                     mov     screenptr, sptr         ' set to start of screen
                        mov     row, #orows             ' clear .. lines
:lines                  mov     col, #ocols/4           ' clear .. columns, 4 chars at a time
:chars                  wrlong  x20202020, screenptr    ' clear 4 chars at a time
                        add     screenptr, #4           ' inc hub ptr
                        djnz    col, #:chars
                        jmpret  taskptr, taskptr        ' return to video code
                        djnz    row, #:lines            ' row=col=0

gohome                  shr     row, #16                ' word[1]
                        mov     posn, row               ' set cursor posn = home

nextchar                wrlong  zero, par               ' clear input char
                        mov     cursorptr, sptr         ' calc cursor hub ptr
                        add     cursorptr, posn
                        rdbyte  cursorchr, cursorptr    ' get the cursor char
waitforchar             jmpret  taskptr,taskptr         ' return to video code
                        test    fcnt, #flash wz         ' flash rate
              if_z      wrbyte  x02, cursorptr          ' cursor \flash cursor
              if_nz     wrbyte  cursorchr, cursorptr    ' char   /
                        rdlong  ch, par wz              ' char avail?
              if_z      jmp     #waitforchar

                        mov     row, ch                 ' take parameter copy
                        wrbyte  cursorchr, cursorptr    ' ensure cursor char replaced in screen buffer

                        and     ch, #$FF                ' remove upper bits

                        cmp     ch, #_cls       wz
              if_z      jmp     #cls
                        cmp     ch, #_can       wz
              if_z      jmp     #cls
                        cmp     ch, #_vt        wz      ' home
              if_z      jmp     #gohome
                        cmp     ch, #_bs        wz
              if_z      jmp     #bs
                        cmp     ch, #_cr        wz
              if_z      jmp     #cr_
                        cmp     ch, #_lf        wz
              if_z      jmp     #lf
                        cmp     ch, #_fs        wz      ' right
              if_z      jmp     #leftright
                        cmp     ch, #_gs        wz      ' left
              if_z      jmp     #leftright
                        cmp     ch, #_rs        wz      ' up
              if_z      jmp     #up
                        cmp     ch, #_us        wz      ' down
              if_z      jmp     #down
                        cmp     ch, #_spc       wc
              if_c      jmp     #nextchar               ' ignore < $20

'for now just display everything else
displaychar             mov     screenptr, sptr         ' start of screen
                        add     screenptr, posn         ' + cursor posn
                        wrbyte  ch, screenptr           ' store char
                        add     posn, #1                ' next posn
validate                cmp     posn, xeos wc           ' eos? end of screen?
                if_c    jmp     #nextchar               ' no
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
