jacgoudsmit/L-Star/(commit log)

2014-11-23 Adding initial schematic and PCB design (Kicad)
    The PCB is VERY rough, but at least all signals are in one layer.
    The schematic was based on the USB proto board that I used to build the prototype.
    [6502.sch, L-Star.kicad_pcb, L-Star.sch, PS2.sch, PowerSupply.sch, Propeller.sch, TVOut.sch, VGA.sch]
2014-11-29 Several improvements
    - Replaced my 1pinTV256 driver by the Debug_1PinTV driver on which it was originally based.
    - Removed the Font_ATARI module; the Debug_1PinTV driver already has a font.
    - Removed the ScreenBufferText module, the assembler code in Debug_1PinTV is much faster anyway
    - Modified the SerKbdTerm module to directly use the 1-pin TV module (and renamed it)
    - The Debug_1PinTV module doesn't handle the string(64,8) to display an '@' as cursor, correctly so it was removed from the main program. This makes the emulation slightly different from the original but the driver shows a blinking cursor anyway, so it's still pretty easy to see where you're typing.
    - Added code to simulate a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
    [1pinTV256.spin, Debug_1pinTV.spin]
2014-12-29 OSI emulator initial check-in
    Work in progress... this doesn't work and is incomplete. Just gathering up what's needed.
    [1pinTV256.spin]
2015-01-02 Initial commit of Fritzing project
    For now, only the breadboard version is complete.
    [L-Star.fzz]
2015-01-04 Updates to Frtizing project
    [L-Star.fzz]
2015-01-18 Got OSI emulation to work (kinda)
    Also changed source files from UTF-16 to ANSI and removed diagrams that were drawn with Propeller characters
    This version of the OSI emulator starts up and runs, but the keyboard still apears a little glitchy. The ACIA emulation is not implemented yet.
    The reason I couldn't get the keyboard working before is that the original hardware used negative logic and our emulator used positive logic. I fixed it by putting two xor's in the keyboard access cog for now, but that made it go over the timing budget which may be what's causing the glitchiness.
    [1pinTV256.spin]
2015-01-18 Fixing compiler error in 1pinTV256.spin
    This got mangled in the previous commit
    [1pinTV256.spin]
2015-01-26 Updating and moving Kicad schematic and PCB
    The current Kicad design includes a number of optional features such as an SRAM chip, a jumper block that allows connecting the Propeller pins to the 65C02 signals, and an expansion port.
    A simpler version without those features will also be made available.
    [6502.sch, L-Star.kicad_pcb, L-Star.sch, PS2.sch, PowerSupply.sch, Propeller.sch, TVOut.sch, VGA.sch]
2015-01-26 Improving keyboard code
    The code in the PS/2 keyboard driver has always bugged me a lot; it depended on "magic numbers" scattered all across the code. This is an attempt to fix it by replacing fields in the VAR section by an array with index constants.
    The normal functionality of getting keys from the keyboard in Spin hasn't been tested, but at least now the OSI keyboard matrix is mostly stable, though it seems that sometimes the shift and caps lock status appears to get out of sync from the keyboard. I'll have to write a test in 6502 assembly and see what's going on. For now, this is enough to type short programs into the OSI emulator anyway.
2015-01-26 Deleting Kicad backup file
2015-01-26 Changed Kicad plot settings
    [L-Star.kicad_pcb, L-Star.sch]
2015-01-27 Changes to schematic and PCB
    Added mounting holes, deleted PCB shorts, deleted extra Prop plug header, changed OSHW logo to a dummy component on the schematic so it doesn't disappear when the netlist is re-imported into pcbnew
    [L-Star.kicad_pcb, L-Star.sch]
2015-02-01 Changes to schematic and PCB design
    Added support for 128K memory (A16 can be controlled by Propeller)
    Updated documentation and footprint library from datasheets on Mouser.com
    [L-Star.kicad_pcb, L-Star.sch]
2015-02-21 Adding KimStar Apple1 software
    Just a little experiment with a Parallax QuickStart board connected to my MicroKim
2015-02-22 Adding "Kimple1"
    The Kimple1 is a mad mutation of the Apple 1 replica software and the MicroKim: it maps the Woz Mon / Apple Basic / Krusader ROM into the high address area, but enables the MicroKim on-board address decoder for addresses below the 8K border. That way, the RAM, RIOT and ROM are visible as usual on $0000-$1FFF and can be studied and controlled with Woz mon.
2015-02-22 Adding MicroPle1 directory and updating readme
    As third experiment in the MicroKim Lobotomy project, I modified the address decoder PASM code a little bit so it only enables the on-board address decoder for the RAM and the RIOT, but not for the EPROM (i.e. only for addresses $0000-$17FF). Also added an extra memory cog instance to map the KIM-1 ROMs in their normal location $1800-$1FFF.
    The result is a mutated Apple-1 / Kim-1 combination, where you can use Woz Mon, Apple Basic, Krusader as usual, but you can also use them to download and program Kim programs. You can use the keys, the display, the KIM ROM routines and everything. But you can also use the Kim monitor to see the code in the W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
2016-02-15 Adding missing pull-up resistors to P31 and Reset
    This makes it possible to run L-Star without Prop-Plug. Thanks cbmeeks for your help!
    Also made some small layout changes in schematic and PCB and updated copyright year.
    [L-Star.kicad_pcb, L-Star.sch]
2016-04-30 Numerous minor changes to schematic and PCB
    [L-Star.kicad_pcb, L-Star.sch]
2016-05-01 Minor changes to PCB
    Moved the two resistors on RES and RXD next to the other resistors, and moved the LED to the edge of the board where most of the other connectors are. Cleaned up lots of traces but not change to the BOM.
    [L-Star.kicad_pcb, L-Star.sch]
2016-05-08 Many small changes to L-Star Plus schematic and PCB
    Including but not limited to:
    - Updated my Kicad to 4.0.2.
    - Removed long list of unneeded libraries
    - Moved power LED to corner near Prop plug
    - Added shorted header for optional power switch (Thanks CBMeeks!)
    - Replaced "POWER IN" by declaration of safe voltages and currents
    - Added voltages to electrolytical caps
    - Removed +5V from jac.lib; it was causing a conflict. Not sure why it was in there in the first place anyway.
    - Added 3V3, VIN and VSUPPLY to POWER netclass. 3V3 replaced "+3.3V" after I updated Kicad
    - Updated dates on schematic and PCB sheets
    - Minor changes to traces on PCB
    [L-Star.kicad_pcb, L-Star.sch]
2016-05-09 Many more minor changes to schematic and PCB (no actual functual changes)
    - Redrew several schematic symbols and footprints
    - Changed resistor footprint to have pins 400mils apart to fit regular resistors slightly better
    - Moved some parts around, most notably the resistor to the LED
    - Renumbered all parts in the schematic
    - Renamed "TV OUT" to "VIDEO OUT"
    -
    [L-Star.kicad_pcb, L-Star.sch]
2016-05-15 Added a slider switch to the PCB, and reduced board size
    The switch that I selected from Mouser didn't quite fit on the board with the components arranged the way they were, so I had to move a lot of stuff around. As a matter of fact, I had to move a LOT of stuff around and decided to try and make the board smaller. I would have liked to get the size under 100mm x 80mm (1/2 Eurocard) but didn't quite make it. Still, the new board is 13% smaller than the old size.
    [L-Star.kicad_pcb, L-Star.sch]
2016-05-15 Minor tweaks to PCB design
    Moved the texts neart the power connector and the LED.
    Moved the expansion connector to be compatible with a future 50-pin header (leaving space for 2 pins to be added at the bottom, 8 pins to be added at the top).
    [L-Star.kicad_pcb]
2016-05-22 Adding initial version of Apple1 with SRAM contol
    I implemented the SRAM control module (make sure you set the jumpers as indicated in the Hardware module) and changed the rest of the code to use the 1-pin keyboard from OBEX. Unfortunately the 1-pin keyboard needs a key press to initialize the timing, so I made it possible to disable the keyboard in the Serial/keyboard module by setting the keyboard data pin to a negative number. The current implementation disables the keyboard, you can only enter input via the serial port.
    This has not been tested yet.
2016-06-05 Deleting .net file, updating .gitignore
    Net list files can be regenerated from the schematic drawing program in Kicad, they don't need to be in source control.
2016-06-06 Fixed jumpers, added Reset, moved LED
    I inadvertently put ~RAMEN on the wrong jumper in Rev2 (J2 instead of J4) so it was impossible to have keyboard, video and SRAM. This moves ~RAMEN to J4 and A16 to J2.
    Also added ~RESET6502 to the jumpers to make it possible to connect a Propeller pin to it
    There was not enough space around the RESET6502 button in Rev2 so I moved the LED to make space. I also moved both pushbutton switches to be parallel and centered between surrounding parts.
    Also some more minor modifications to PCB and schematic.
    [L-Star.kicad_pcb, L-Star.sch]
2016-06-10 Rev 3 Finished
    Made all the soldering pads a little bigger, and made the pads for the voltage regulators a little smaller to leave more room for the switch. Many more small tweaks to footprints and PCB.
    [L-Star.kicad_pcb, L-Star.sch]
2016-06-11 Tweaks
    Saved the Kicad project file and made the copper layers visible
    [L-Star.kicad_pcb]
2016-08-28 Rev.4 schematic and PCB
    Replaced the expansion connector by a 50-pin header so I could add all the signals including BE (I added a pull-up resistor for the BE pin). It's even possible to replicate the entire jumper block on an expension board or an external connector now. Another possibility is to cut off the entire right side of the board (with all the connections and the jumper block) or leave it unpopulated, and make the necessary connections via the expansion port. The new connector is backwards compatible with the old one from the Rev.1, Rev.2 and Rev.3 boards.
    Rewired almost the entire board to make it smaller again; I finally got it to fit into slightly over 80x100mm (you'll have to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
    [L-Star.kicad_pcb, L-Star.sch]
2016-08-28 Minor Tweaks
    Made the pad size of the 2x25 connector slightly bigger and saved it in my own library.
    Also tweaked a few traces a little to clean them up
    [L-Star.kicad_pcb]
2016-10-08 PCB Revision 5
    I had Rev 4 manufactured at OSHPark and ran into the following problems:
    1. The pad-to-soldermask clearance was too big (.0078 inches) so the copper of the flood planes was exposed
    2. The flood plane clearance was too small so in combination with the above, it was too easy to short pads to flood planes
    3. In a few places, parts were too close together, which also made it too easy to cause short circuits
    4. Some vias didn't get drilled because apparently the drill bit broke while the factory was processing my board
    5. I had moved the mounting hole on the bottom left under the SRAM chip but that really wasn't a good location
    To fix this, I made the following changes:
    - Changed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
    [L-Star.kicad_pcb, L-Star.sch]
2016-11-01 Nudged the 3.3V Electrolytic over a bit
    When soldering the Rev.5 PCB, the only small problem was that the two electrolytic capacitors were just a little too close together. They still fit but space is tight, so I moved the one that's closest to the SRAM chip over a bit (off the grid). Nothing else was changed so this PCB is ready for production.
    [L-Star.kicad_pcb]
2016-11-01 Small changes to Apple 1 SRAM project
    - Added "lock" parameter to 1-pin keyboard driver to allow initialization of (virtual) numlock/capslock/scrollock (the lights on the keyboard don't work with 1-pin communication)
    - Changed the SerKbd1TV initialization so it starts with numlock/capslock enabled
    - Changed the startup messages slightly
2016-12-12 Rev 5B: Changed web address on PCB silkscreen
    [L-Star.kicad_pcb]
2016-12-17 Adding printable build instructions
2016-12-23 Add Demo1 project for SimpleIDE
    SimpleIDE is the new Integrated Development Environment for the Propeller.
    The first demo program shows how the Propeller has access to the 65C02 bus,
    and demonstrates the reset cycle. It can also be used as the basis for other
    programs.
2016-12-28 Added demo2.c sample/tutorial program
    This program demonstrates how to start a separate cog that simulates ROM and RAM
2016-12-28 Adding L-Star Lite: schematic for the minimal version
    This will probably not be maintained in the future but it should help those who don't want to buy or build the L-Star Plus, but just want to play with a bitbanged 6502 on a breadboard or something (there is no PCB design)
    [L-Star.sch]
2018-03-20 Modified Apple1 project for use with PropellerIDE
    PropellerIDE (really BSTC and OpenSpin) apparently look for included Spin files (OBJ section) in the library before looking in the current directory, which caused a problem with "clock.spin" because a module with that name also exists in the library. I renamed the module to work around the problem.
    Also, PropellerIDE generates files with .binary extensions which I added to .gitignore.
    Also updated copyright year of the Apple1.spin module and added a patch to make the degree symbol go away. The degree symbol is shown when Woz mon tries to set the direction register of the PIA, but in our emulation, there is no such register and it doesn't ne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
2018-03-25 Modified Apple1SRAM project to work with PropellerIDE
    Renamed the clock.spin module because PropellerIDE (actually BSTC and OpenSpin) have a bug in the order in which they search for modules, so they picked up clock.spin from the library instead of in the project directory.
2018-05-07 Changed OSI video driver to show all characters in video Memory
    The video driver was once the start of the cooperation between Vince Briel and I. He didn't know how to modify the 1 pin video driver for his Superboard III project, and I didn't know how the original video hardware of the Superboard II worked. There were a few misunderstandings and long story short, the video driver showed a 25x25 character window that would be used by BASIC. But actually the original hardware shows the entire 32x32 matrix and relies on the software not to use the memory locations that are at the edge of the screen.
    This commit fixes that: the entire matrix is shown, as much as possible anyway. In NTSC, there a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
    [1pinTV256.spin]
2018-06-10 Added PET-2001 project (doesn't work yet)
    This is the "first sign of life" commit for the PET-2001 project.
    The top level file (PET2001.spin) sets up the SRAM chip to represent 32KB RAM, and runs the 1-pin video module with a PET font and a memory module with the necessary ROMs for a PET-2001 with Basic-2 installed. There is no I/O yet: the area in memory where normally two PIAs and a VIA would be, is decoded to an 8K ROM wasteland. This doesn't make the Kernal happy: it drops out to the machine language monitor instead of showing "COMMODORE BASIC". There is no blinking cursor because there's no IRQ that should normally occur 60 or 50 times per second. And the MLM output is garbled; looks l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
    [Debug_1pinTV.spin]
2018-11-04 Copied Apple1 project to Apple1SuperCon2018Addon
    I made a special version of the Apple 1 project at the Hackaday SuperCon, mounted on the Add-on board that they handed out to all everyone, along with the Supercon Badge.
2018-11-11 Updated SuperCon Badge Add-on version of the software
    Cleaned up the terminal and main modules and renamed the terminal module (Git sees this as a delete and create, sorry).
    Removed the 1-pin TV module as it's not needed for this project.
2018-11-20 Updated L-Star Lite
    Designed a PCB for L-Star Lite
    Also updated KiCad to 5.0.1.4 which insists on creating "rescue" libraries from the old files. I'll figure out how to clean everything up later.
    [L-Star.kicad_pcb, L-Star.sch]
