jacgoudsmit/L-Star/(notices)

Notices in the files:
Hardware/Kicad/L-StarPlus/L-Star.kicad_pcb:
Open Source Hardware (MIT License)
Hardware/Kicad/L-StarLite/L-Star.sch:
(C) 2018 Jac Goudsmit
